iJebus/Salad_Fork/STL/Common/Skirts/Foot_B_heatset_x1.stl

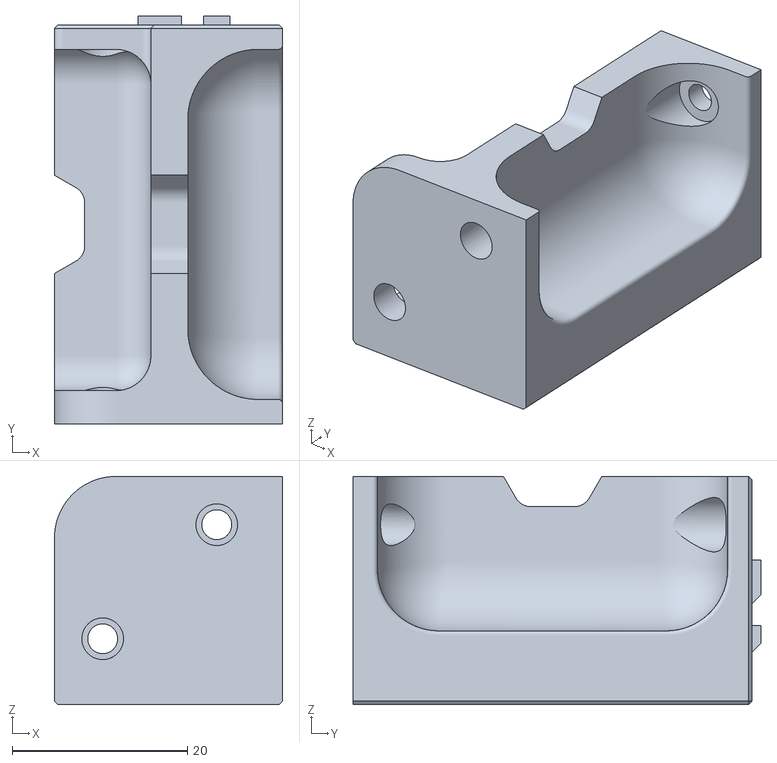
[picture p1: CAD file, 2024-07-21]
STL/Common/Skirts/Foot_B_heatset_x1.stl
26.0 x 46.5 x 26.0
