iJebus/Salad_Fork/(list of files, cad)

Other CAD files:
STL/Common/Skirts/Foot_A_heatset_x1.stl
