iJebus/Salad_Fork/(commit log)

2023-01-15 Fix rear bottom z assembly instructions
2024-07-21 Add optional heatset feet
    Experimental, not tested.
    [Foot_A_heatset_x1.stl, Foot_B_heatset_x1.stl]
